f-reiling/vdMotCtrl/_doc/IMG_20200206_205902.jpg

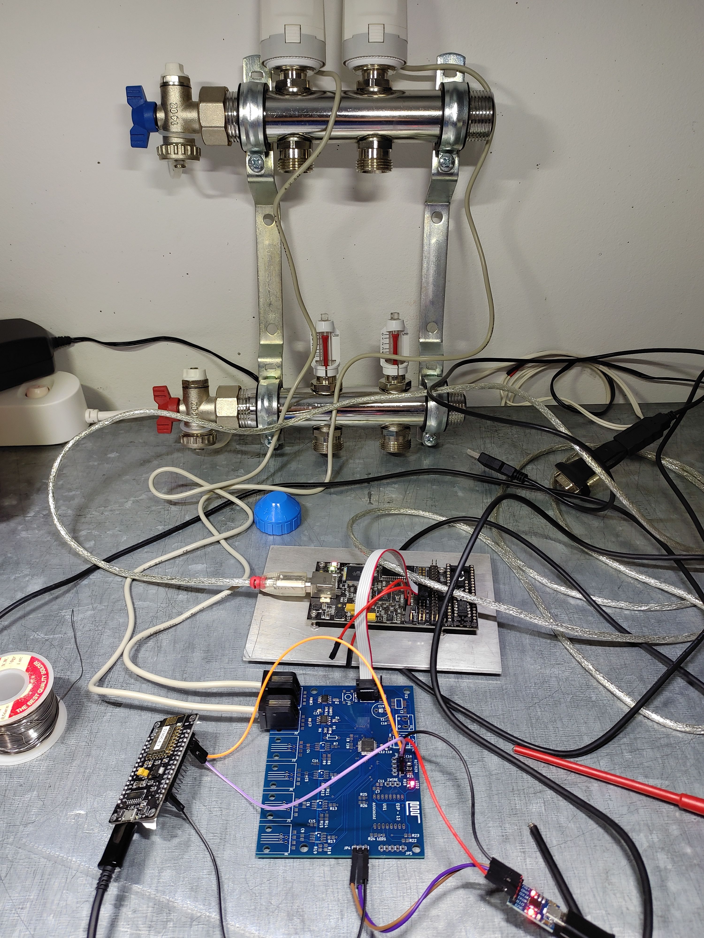
_doc/IMG_20200206_205902.jpg
