f-reiling/vdMotCtrl/README.md

# vdMotCtrl
Controls up to 6 HmIP-VDMOT drives via I2C or UART interface. 

PCB uses ATmega168P as controller with L9110s as drivers. External interfaces are I2C and UART. Socket for ESP12 is also availble for wireless connection. 2 PCBs can be stacked, communication is planned via I2C then.
