f-reiling/vdMotCtrl/pcb/vdmotCtrl_v1.brd

## EAGLE design pcb/vdmotCtrl_v1.brd (2020-02-02)

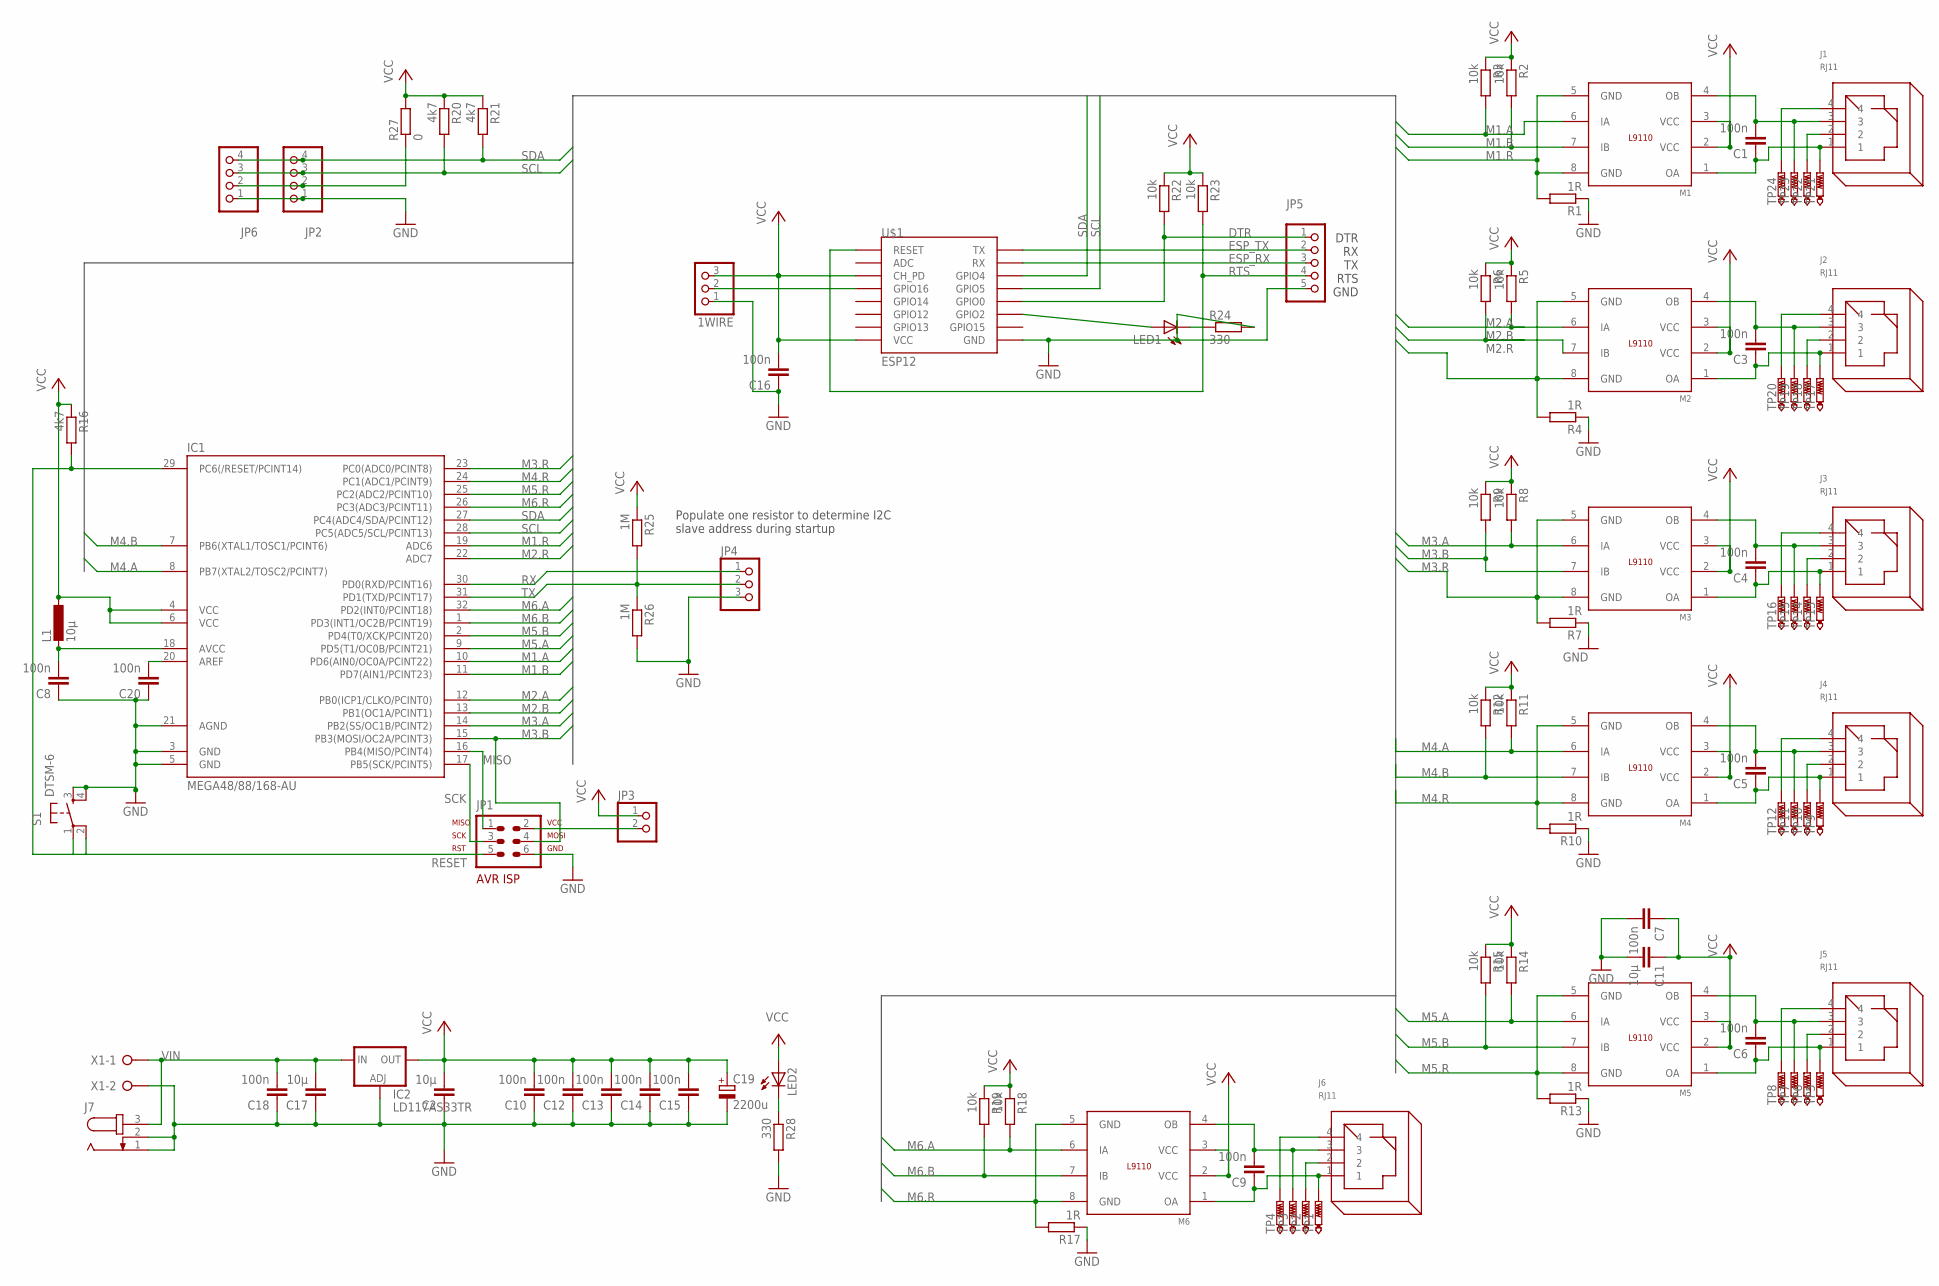
[picture p2: schematic vdmotCtrl_v1.sch]

Parts:
1WIRE: PINHD-1X3; 1X03
C1, C3, C4, C5, C6, C7, C8, C9, C10, C12, C13, C14, C15, C16, C18, C20: 100n; C0805
C2, C11, C17: 10µ; C0805
C19: 2200u; E5-10,5
IC1: MEGA48/88/168-AU; TQFP32-08
IC2: LD117AS33TR; SOT223
J1, J2, J3, J4, J5, J6: RJ11
J7: JACK-PLUG0; SPC4077
JP1: AVR-ISP-6VERT; AVR-ISP-6
JP2, JP6: PINHD-1X4; 1X04
JP3: PINHD-1X2; 1X02
JP4: PINHD-1X3; 1X03
JP5: PINHD-1X5; 1X05
L1: 10µ; 0204/7
LED1, LED2: RED; SML0805
M1, M2, M3, M4, M5, M6: L9110; SO8P
R1, R4, R7, R10, R13, R17: 1R; R0805
R2, R3, R5, R6, R8, R9, R11, R12, R14, R15, R18, R19, R22, R23: 10k; R0805
R16, R20, R21: 4k7; R0805
R24, R28: 330; R0805
R25, R26: 1M; R0805
R27: 0; M0805
S1: DTSM-6
TP1, TP2, TP3, TP4, TP5, TP6, TP7, TP8, TP9, TP10, TP11, TP12, TP13, TP14, TP15, TP16, TP17, TP18, TP19, TP20, TP21, TP22, TP23, TP24: PTR1TP15SQ; TP15SQ
U$1: ESP12
X1: W237-02P; W237-132

Connections:
DTR: JP5.1, R22.2, U$1.GPIO0
ESP_RX: JP5.3, U$1.RX
ESP_TX: JP5.2, U$1.TX
GND: 1WIRE.1, C2.1, C7.2, C8.1, C10.1, C11.2, C12.1, C13.1, C14.1, C15.1, C16.1, C17.1, C18.1, C19.-, C20.1, IC1.3 (GND), IC1.5 (GND), IC1.21 (AGND), IC2.1 (ADJ), J7.1, J7.2, JP1.6, JP2.1, JP4.3, JP5.5, JP6.1, R1.1, R4.1, R7.1, R10.1, R13.1, R17.1, R24.2, R26.2, R28.2, S1.3, S1.4, U$1.GND, X1.2
M1.A: IC1.10 (PD6(AIN0/OC0A/PCINT22)), M1.6 (IA), R3.2
M1.B: IC1.11 (PD7(AIN1/PCINT23)), M1.7 (IB), R2.2
M1.R: IC1.19 (ADC6), M1.5 (GND), M1.8 (GND), R1.2
M2.A: IC1.12 (PB0(ICP1/CLKO/PCINT0)), M2.6 (IA), R5.2
M2.B: IC1.13 (PB1(OC1A/PCINT1)), M2.7 (IB), R6.2
M2.R: IC1.22 (ADC7), M2.5 (GND), M2.8 (GND), R4.2
M3.A: IC1.14 (PB2(SS/OC1B/PCINT2)), M3.6 (IA), R8.2
M3.B: IC1.15 (PB3(MOSI/OC2A/PCINT3)), JP1.4, M3.7 (IB), R9.2
M3.R: IC1.23 (PC0(ADC0/PCINT8)), M3.5 (GND), M3.8 (GND), R7.2
M4.A: IC1.8 (PB7(XTAL2/TOSC2/PCINT7)), M4.6 (IA), R11.2
M4.B: IC1.7 (PB6(XTAL1/TOSC1/PCINT6)), M4.7 (IB), R12.2
M4.R: IC1.24 (PC1(ADC1/PCINT9)), M4.5 (GND), M4.8 (GND), R10.2
M5.A: IC1.9 (PD5(T1/OC0B/PCINT21)), M5.6 (IA), R14.2
M5.B: IC1.2 (PD4(T0/XCK/PCINT20)), M5.7 (IB), R15.2
M5.R: IC1.25 (PC2(ADC2/PCINT10)), M5.5 (GND), M5.8 (GND), R13.2
M6.A: IC1.32 (PD2(INT0/PCINT18)), M6.6 (IA), R18.2
M6.B: IC1.1 (PD3(INT1/OC2B/PCINT19)), M6.7 (IB), R19.2
M6.R: IC1.26 (PC3(ADC3/PCINT11)), M6.5 (GND), M6.8 (GND), R17.2
MISO: IC1.16 (PB4(MISO/PCINT4)), JP1.1
unnamed: C1.1, J1.1, M1.1 (OA), TP21.TP
unnamed: C1.2, J1.3, M1.4 (OB), TP23.TP
unnamed: C3.1, J2.1, M2.1 (OA), TP17.TP
unnamed: C3.2, J2.3, M2.4 (OB), TP19.TP
unnamed: C4.1, J3.1, M3.1 (OA), TP13.TP
unnamed: C4.2, J3.3, M3.4 (OB), TP15.TP
unnamed: C5.1, J4.1, M4.1 (OA), TP9.TP
unnamed: C5.2, J4.3, M4.4 (OB), TP11.TP
unnamed: C6.1, J5.1, M5.1 (OA), TP5.TP
unnamed: C6.2, J5.3, M5.4 (OB), TP7.TP
unnamed: C20.2, IC1.20 (AREF)
unnamed: C8.2, IC1.18 (AVCC), L1.2
unnamed: J6.2, TP2.TP
unnamed: LED1.A, U$1.GPIO2
unnamed: C9.1, J6.1, M6.1 (OA), TP1.TP
unnamed: C9.2, J6.3, M6.4 (OB), TP3.TP
unnamed: LED1.C, R24.1
unnamed: J6.4, TP4.TP
unnamed: J1.2, TP22.TP
unnamed: J1.4, TP24.TP
unnamed: JP1.2, JP3.2
unnamed: J2.2, TP18.TP
unnamed: J2.4, TP20.TP
unnamed: J3.4, TP16.TP
unnamed: J3.2, TP14.TP
unnamed: J4.4, TP12.TP
unnamed: J4.2, TP10.TP
unnamed: J5.4, TP8.TP
unnamed: J5.2, TP6.TP
unnamed: JP2.2, JP6.2, R27.1
unnamed: 1WIRE.2, U$1.GPIO16
unnamed: LED2.C, R28.1
RESET: IC1.29 (PC6(/RESET/PCINT14)), JP1.5, R16.2, S1.1, S1.2
RTS: JP5.4, R23.2, U$1.RESET
RX: IC1.30 (PD0(RXD/PCINT16)), JP4.1
SCK: IC1.17 (PB5(SCK/PCINT5)), JP1.3
SCL: IC1.28 (PC5(ADC5/SCL/PCINT13)), JP2.3, JP6.3, R20.2, U$1.GPIO5
SDA: IC1.27 (PC4(ADC4/SDA/PCINT12)), JP2.4, JP6.4, R21.2, U$1.GPIO4
TX: IC1.31 (PD1(TXD/PCINT17)), JP4.2, R25.2, R26.1
VCC: 1WIRE.3, C2.2, C7.1, C10.2, C11.1, C12.2, C13.2, C14.2, C15.2, C16.2, C19.+, IC1.4 (VCC), IC1.6 (VCC), IC2.4 (OUT), JP3.1, L1.1, LED2.A, M1.2 (VCC), M1.3 (VCC), M2.2 (VCC), M2.3 (VCC), M3.2 (VCC), M3.3 (VCC), M4.2 (VCC), M4.3 (VCC), M5.2 (VCC), M5.3 (VCC), M6.2 (VCC), M6.3 (VCC), R2.1, R3.1, R5.1, R6.1, R8.1, R9.1, R11.1, R12.1, R14.1, R15.1, R16.1, R18.1, R19.1, R20.1, R21.1, R22.1, R23.1, R25.1, R27.2, U$1.CH_PD, U$1.VCC
VIN: C17.2, C18.2, IC2.3 (IN), J7.3, X1.1

Notes on the sheet:
DTR RX TX RTS GND
Populate one resistor to determine I2C slave address during startup

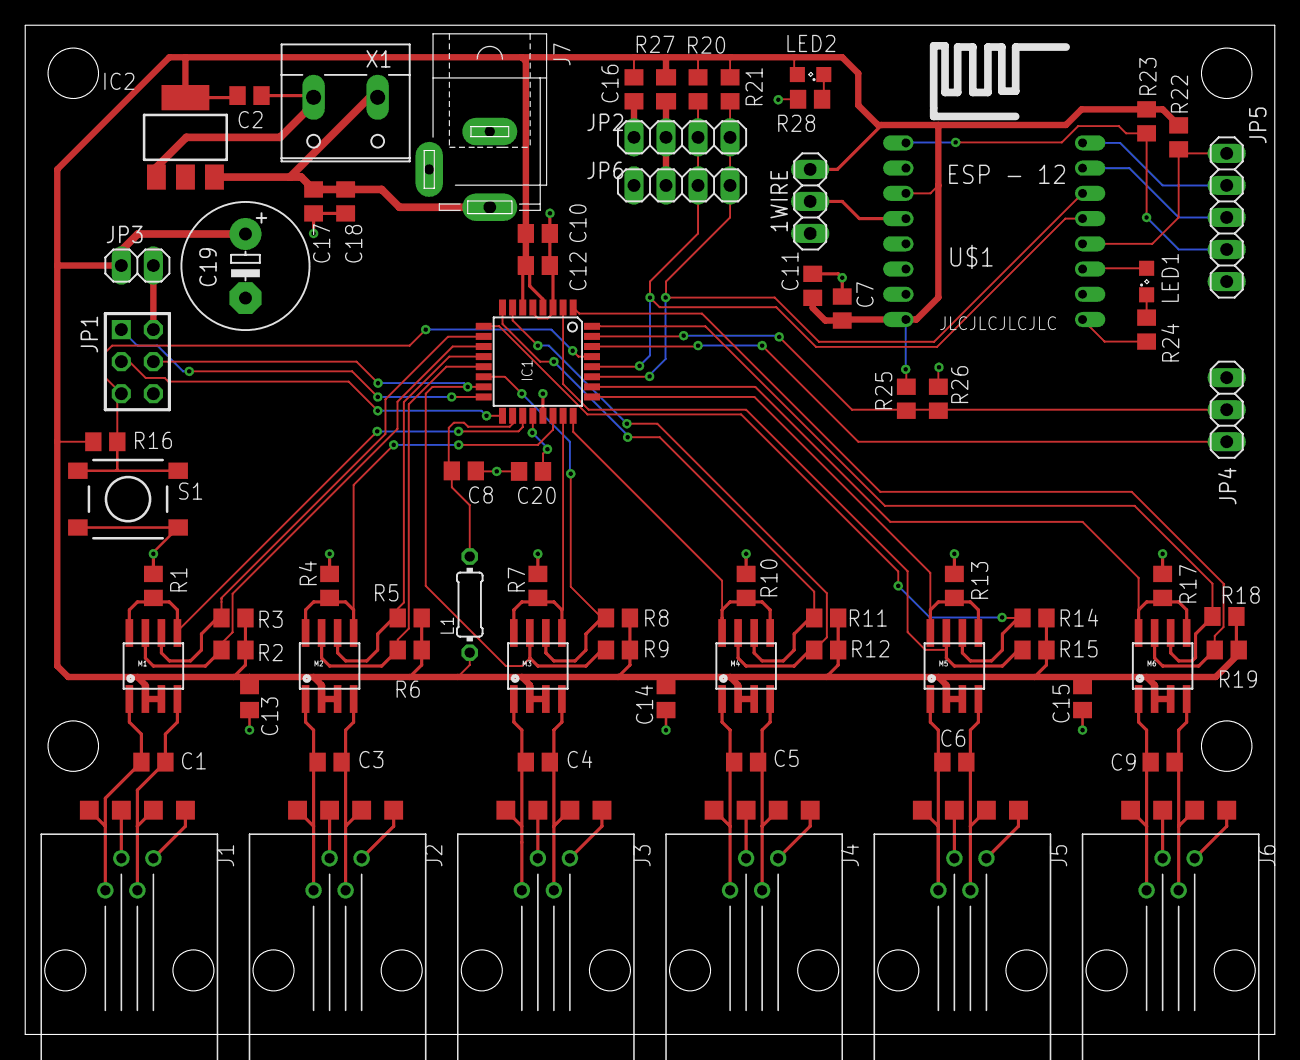
[picture p3: board vdmotCtrl_v1.brd from above]

Board: 2 copper layers, 99.1 x 80.0 mm, 100 parts (0 on the bottom side), 64 nets.
