f-reiling/vdMotCtrl/(threads)

Thread 1 (2020-10-14):

Gerber files

nliaudat, 2020-10-14:
Hi,
Many thanks for sharing your project.
I want to print a PCB and perhaps adapt it to 8 channels.
Can you upload the Gerber files ?
Regards

f-reiling, 2020-11-02:
Hi,
for sure I can upload the gerber files, but wouldn't ir be better to use the schematic and board file instead?
With the currently used µC only 6 channels are possible as there are no more ADC channels and GPIOs left. You have to use a different processor then.
The PCB is designed to be stacked multiple times, so you can easily the number of supported channels.

regards,
Florian

nliaudat, 2020-11-02:
Hi.
I've make [my own from scratch](https://easyeda.com/editor#id=|9c2b2046956d40d5a3dfaaff5a59ae15|f991bfc7778a4826b7bb388ec20c12c1|9d290d6246f34ef3a0e73d7fb4febcd4|5bbaee768a954daebe4c315700dceec6|932f8d4777634f21b9d7e40c2aa38db7) printable at jlcpcb. I use only one Esp32 with 2 shift registers to extend IO. Can you have a look ? I have very bad skills in electronics and that's my first pcb project.
Perhaps if it's not too bad, you could add it as a second version of your project.
Regards

linuxdep, 2021-01-29:
Do you have more information about the project? I am also considering whether it is worth building the controller myself or whether it is better to use the ready-made Homematic solution.

f-reiling, 2021-01-30:
which information do you need?

nliaudat, 2021-01-30:
look at https://github.com/nliaudat/esp32_8ch_motor_shield.
I've done a homematic replacement board from scratch
