f-reiling/vdMotCtrl/(commit log)

2020-02-02 added prototype PCB
    [vdmotCtrl_v1.brd, vdmotCtrl_v1.sch]
2020-02-02 first running version. 2 drives. adaption working, movement working. some uart commands implemented for tests.
2020-02-06 fixed I2C communication
2020-02-06 added picture of prototype
2020-02-13 changed i2c command structure
2020-02-13 added command: move relative fixed I2C ST mode improved task load
    [i2ccmdhndlr.cpp, main.cpp]
2020-05-01 added uart support for 6 drives. added nvm default values
